erwin620/PrintMAQ/HMI/imagenes/ajustes.png

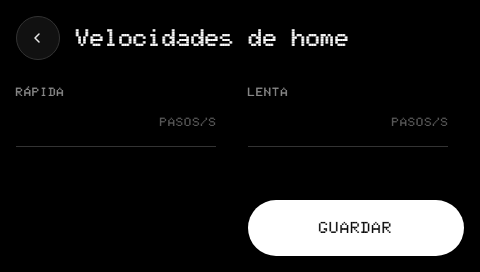
HMI/imagenes/ajustes.png
