erwin620/PrintMAQ/HMI/imagenes/en/ajustes_p.png

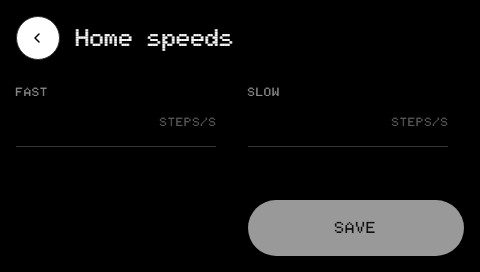
HMI/imagenes/en/ajustes_p.png
