erwin620/PrintMAQ/HMI/imagenes/en/jog.png

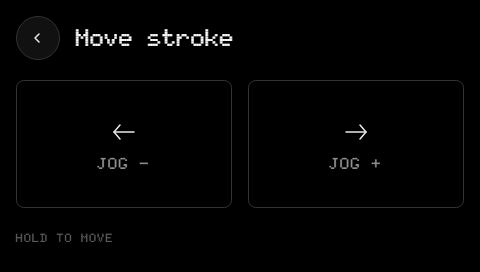
HMI/imagenes/en/jog.png
