erwin620/PrintMAQ/HMI/imagenes/en/jog_p.png

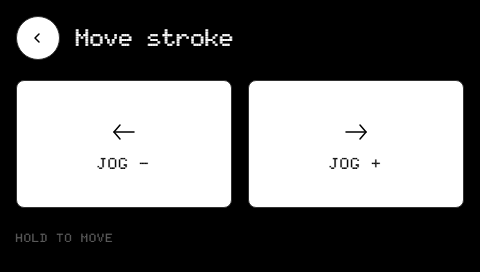
HMI/imagenes/en/jog_p.png
