erwin620/PrintMAQ/HMI/imagenes/en/main.png

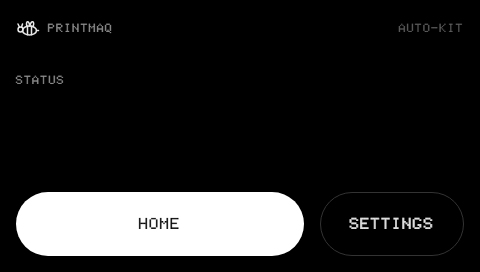
HMI/imagenes/en/main.png
