erwin620/PrintMAQ/HMI/imagenes/en/menu.png

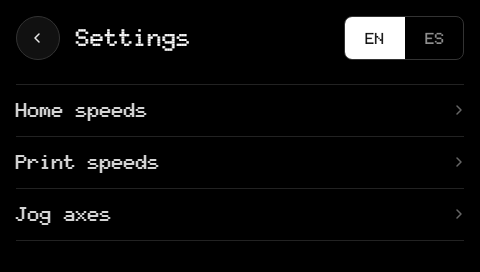
HMI/imagenes/en/menu.png
