erwin620/PrintMAQ/HMI/imagenes/impresion_p.png

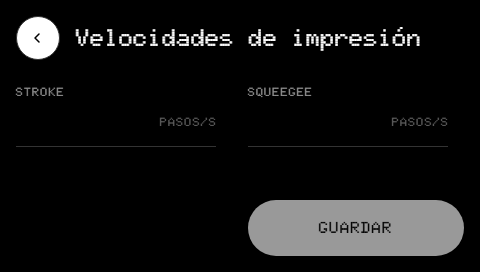
HMI/imagenes/impresion_p.png
