erwin620/PrintMAQ/HMI/imagenes/menu.png

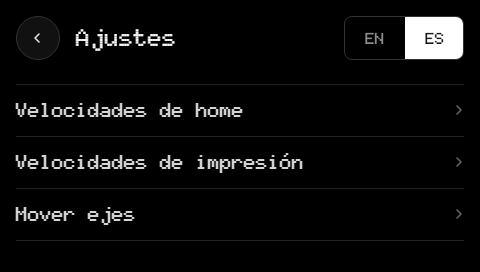
HMI/imagenes/menu.png
