erwin620/PrintMAQ/HMI/imagenes/menu_p.png

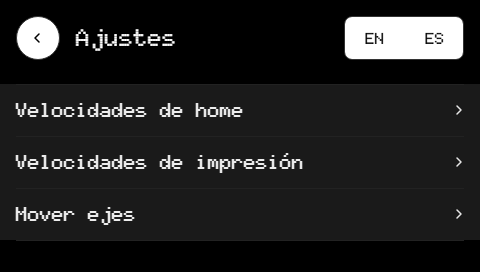
HMI/imagenes/menu_p.png
