erwin620/PrintMAQ/HMI/imagenes/teclado.png

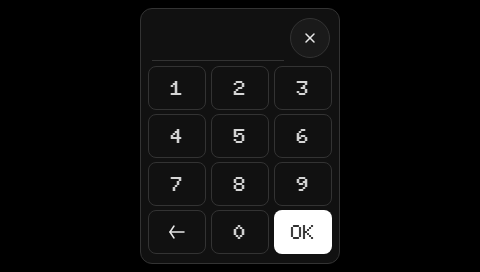
HMI/imagenes/teclado.png
