erwin620/PrintMAQ/HMI/imagenes/teclado_p.png

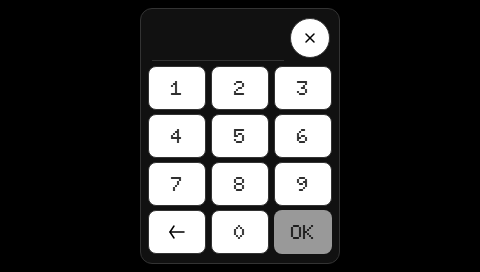
HMI/imagenes/teclado_p.png
