erwin620/PrintMAQ/STM32/Core/Src/main.c

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
/* Includes ------------------------------------------------------------------*/
#include "main.h"
#include "cmsis_os.h"

/* USER CODE BEGIN Includes */
#include "machine.h"
#include "settings.h"
#include "hmi.h"
/* USER CODE END Includes */

/* Definitions for MachineTask */
osThreadId_t MachineTaskHandle;
const osThreadAttr_t MachineTask_attributes = {
  .name = "MachineTask",
  .stack_size = 256 * 4,
  .priority = (osPriority_t) osPriorityAboveNormal,
};
/* Definitions for HmiTask */
osThreadId_t HmiTaskHandle;
const osThreadAttr_t HmiTask_attributes = {
  .name = "HmiTask",
  .stack_size = 256 * 4,
  .priority = (osPriority_t) osPriorityNormal,
};
/* Definitions for LedTask */
osThreadId_t LedTaskHandle;
const osThreadAttr_t LedTask_attributes = {
  .name = "LedTask",
  .stack_size = 128 * 4,
  .priority = (osPriority_t) osPriorityLow,
};
void SystemClock_Config(void);
void StartDefaultTask(void *argument);
void StartTask03(void *argument);
void StartTask04(void *argument);

/* USER CODE BEGIN PFP */
static void MX_GPIO_Init(void);
static void DWT_Init(void);
static void StatusLed_Update(void);
#ifdef PRUEBA_BANCO_SIN_HMI
static void KeyUp_Update(void);
#endif
/* USER CODE END PFP */

/**
  * @brief  The application entry point.
  * @retval int
  */
int main(void)
{

  /* MCU Configuration--------------------------------------------------------*/

  /* Reset of all peripherals, Initializes the Flash interface and the Systick. */
  HAL_Init();

  /* Configure the system clock */
  SystemClock_Config();

  /* Initialize all configured peripherals */
  /* USER CODE BEGIN 2 */
  MX_GPIO_Init();
  DWT_Init();
  Settings_Init();
  Machine_Init();
  Hmi_Init();
  /* USER CODE END 2 */

  /* Init scheduler */
  osKernelInitialize();

  /* USER CODE BEGIN RTOS_MUTEX */
  /* add mutexes, ... */
  /* USER CODE END RTOS_MUTEX */

  /* USER CODE BEGIN RTOS_SEMAPHORES */
  /* add semaphores, ... */
  /* USER CODE END RTOS_SEMAPHORES */

  /* USER CODE BEGIN RTOS_TIMERS */
  /* start timers, add new ones, ... */
  /* USER CODE END RTOS_TIMERS */

  /* USER CODE BEGIN RTOS_QUEUES */
  /* add queues, ... */
  /* USER CODE END RTOS_QUEUES */

  /* Create the thread(s) */
  /* creation of MachineTask */
  MachineTaskHandle = osThreadNew(StartDefaultTask, NULL, &MachineTask_attributes);

  /* creation of HmiTask */
  HmiTaskHandle = osThreadNew(StartTask03, NULL, &HmiTask_attributes);

  /* creation of LedTask */
  LedTaskHandle = osThreadNew(StartTask04, NULL, &LedTask_attributes);

  /* USER CODE BEGIN RTOS_THREADS */
  /* add threads, ... */
  /* USER CODE END RTOS_THREADS */

  /* USER CODE BEGIN RTOS_EVENTS */
  /* add events, ... */
  /* USER CODE END RTOS_EVENTS */

  /* Start scheduler */
  osKernelStart();

  /* We should never get here as control is now taken by the scheduler */

  /* Infinite loop */
  /* USER CODE BEGIN WHILE */
  /* Inalcanzable: osKernelStart no retorna y el trabajo lo hacen las tareas. */
  while (1)
  {
    /* USER CODE END WHILE */

    /* USER CODE BEGIN 3 */
  }
  /* USER CODE END 3 */
}

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
/* USER CODE BEGIN 4 */

/* Configura los LEDs, las salidas STEP/DIR de los ejes y las entradas de los sensores. */
static void MX_GPIO_Init(void)
{
  GPIO_InitTypeDef GPIO_InitStruct = {0};

  __HAL_RCC_GPIOA_CLK_ENABLE();
  __HAL_RCC_GPIOB_CLK_ENABLE();
  __HAL_RCC_GPIOC_CLK_ENABLE();

  /* LEDs activos en bajo: SET = apagado */
  HAL_GPIO_WritePin(LED_D2_PORT, LED_D2_PIN | LED_D3_PIN, GPIO_PIN_SET);
  GPIO_InitStruct.Pin = LED_D2_PIN | LED_D3_PIN;
  GPIO_InitStruct.Mode = GPIO_MODE_OUTPUT_PP;
  GPIO_InitStruct.Pull = GPIO_NOPULL;
  GPIO_InitStruct.Speed = GPIO_SPEED_FREQ_LOW;
  HAL_GPIO_Init(LED_D2_PORT, &GPIO_InitStruct);

  /* PUL/DIR en reposo = LOW (sin corriente por el opto del DM556) */
  HAL_GPIO_WritePin(STROKE_PUL_PORT, STROKE_PUL_PIN, GPIO_PIN_RESET);
  HAL_GPIO_WritePin(STROKE_DIR_PORT, STROKE_DIR_PIN, GPIO_PIN_RESET);
  GPIO_InitStruct.Pin = STROKE_PUL_PIN | STROKE_DIR_PIN;
  GPIO_InitStruct.Mode = GPIO_MODE_OUTPUT_PP;
  GPIO_InitStruct.Pull = GPIO_NOPULL;
  GPIO_InitStruct.Speed = GPIO_SPEED_FREQ_HIGH;
  HAL_GPIO_Init(STROKE_PUL_PORT, &GPIO_InitStruct);

  HAL_GPIO_WritePin(SQUEEGEE_PUL_PORT, SQUEEGEE_PUL_PIN, GPIO_PIN_RESET);
  HAL_GPIO_WritePin(SQUEEGEE_DIR_PORT, SQUEEGEE_DIR_PIN, GPIO_PIN_RESET);
  GPIO_InitStruct.Pin = SQUEEGEE_PUL_PIN | SQUEEGEE_DIR_PIN;
  HAL_GPIO_Init(SQUEEGEE_PUL_PORT, &GPIO_InitStruct);

  /* Sensores NPN de colector abierto: necesitan pull-up */
  GPIO_InitStruct.Pin = STROKE_HOME_PIN | SQUEEGEE_HOME_PIN;
  GPIO_InitStruct.Mode = GPIO_MODE_INPUT;
  GPIO_InitStruct.Pull = GPIO_PULLUP;
  HAL_GPIO_Init(STROKE_HOME_PORT, &GPIO_InitStruct);

  GPIO_InitStruct.Pin = PRENDA_PIN;
  HAL_GPIO_Init(PRENDA_PORT, &GPIO_InitStruct);

#ifdef PRUEBA_BANCO_SIN_HMI
  /* El boton no tiene resistencia externa: sin pull-down la entrada quedaria flotando */
  GPIO_InitStruct.Pin = KEY_UP_PIN;
  GPIO_InitStruct.Mode = GPIO_MODE_INPUT;
  GPIO_InitStruct.Pull = GPIO_PULLDOWN;
  HAL_GPIO_Init(KEY_UP_PORT, &GPIO_InitStruct);
#endif
}

/* El contador de ciclos DWT es la base de tiempo de los pulsos y del filtro del sensor. */
static void DWT_Init(void)
{
  CoreDebug->DEMCR |= CoreDebug_DEMCR_TRCENA_Msk;
  DWT->CYCCNT = 0U;
  DWT->CTRL |= DWT_CTRL_CYCCNTENA_Msk;
}

/* D3 refleja el estado de la maquina: apagado = sin home, parpadeo lento = haciendo home,
   fijo = en home, parpadeo muy lento = jog, parpadeo medio = imprimiendo, parpadeo rapido = error. */
static void StatusLed_Update(void)
{
  uint32_t tick = HAL_GetTick();
  uint8_t led_on;

  switch (Machine_GetState())
  {
    case MAQ_HACIENDO_HOME: led_on = ((tick / 250U) % 2U) == 0U; break;
    case MAQ_EN_HOME:       led_on = 1U;                         break;
    case MAQ_JOG:           led_on = ((tick / 500U) % 2U) == 0U; break;
    case MAQ_IMPRIMIENDO:   led_on = ((tick / 125U) % 2U) == 0U; break;
    case MAQ_ERROR:         led_on = ((tick / 62U) % 2U) == 0U;  break;
    /* Destello corto en vez de apagado: distingue "esperando home" de "firmware detenido" */
    case MAQ_SIN_HOME:
    default:                led_on = (tick % 2000U) < 60U;       break;
  }

  HAL_GPIO_WritePin(LED_D3_PORT, LED_D3_PIN, led_on ? GPIO_PIN_RESET : GPIO_PIN_SET);
}

#ifdef PRUEBA_BANCO_SIN_HMI
/* Se llama cada 20 ms desde LedTask: exigir dos lecturas seguidas presionado filtra el rebote.
   Solo el flanco de presion pide el home; mantener el boton no lo repite. */
static void KeyUp_Update(void)
{
  static uint8_t prev_pressed = 0U;
  static uint8_t last_raw = 0U;
  uint8_t raw = (HAL_GPIO_ReadPin(KEY_UP_PORT, KEY_UP_PIN) == KEY_UP_ACTIVE) ? 1U : 0U;
  uint8_t pressed = (raw && last_raw) ? 1U : 0U;
  Machine_State_t st = Machine_GetState();

  /* D2 refleja el boton mientras ningun eje lo usa como indicador de pasos: confirma en banco que PA0 se lee */
  if (st == MAQ_SIN_HOME || st == MAQ_ERROR)
  {
    HAL_GPIO_WritePin(LED_D2_PORT, LED_D2_PIN, raw ? GPIO_PIN_RESET : GPIO_PIN_SET);
  }

  if (pressed && !prev_pressed)
  {
    Machine_RequestHome();
  }
  prev_pressed = pressed;
  last_raw = raw;
}
#endif

/* USER CODE END 4 */

/* USER CODE BEGIN Header_StartDefaultTask */
/**
  * @brief  Function implementing the defaultTask thread.
  * @param  argument: Not used
  * @retval None
  */
/* USER CODE END Header_StartDefaultTask */
void StartDefaultTask(void *argument)
{
  /* USER CODE BEGIN 5 */
  /* Los pulsos del motor no se generan aqui sino en la interrupcion de TIM7: una tarea
     tendria jitter y estaria limitada a 1 paso por tick del RTOS. */
  for(;;)
  {
    Machine_Update();
    /* Misma tarea que Machine_Update: ningun movimiento puede arrancar a mitad de una grabacion */
    Settings_Update(Machine_IsIdle());
    osDelay(1);
  }
  /* USER CODE END 5 */
}

/* USER CODE BEGIN Header_StartTask03 */
/**
* @brief Function implementing the HmiTask thread.
* @param argument: Not used
* @retval None
*/
/* USER CODE END Header_StartTask03 */
void StartTask03(void *argument)
{
  /* USER CODE BEGIN StartTask03 */
  /* A 9600 baudios llega como maximo un byte por milisegundo y la interrupcion los bufferea,
     por lo que revisar cada 2 ms no pierde datos. */
  for(;;)
  {
    Hmi_Update();
    osDelay(2);
  }
  /* USER CODE END StartTask03 */
}

/* USER CODE BEGIN Header_StartTask04 */
/**
* @brief Function implementing the myTask04 thread.
* @param argument: Not used
* @retval None
*/
/* USER CODE END Header_StartTask04 */
void StartTask04(void *argument)
{
  /* USER CODE BEGIN StartTask04 */
  for(;;)
  {
#ifdef PRUEBA_BANCO_SIN_HMI
    KeyUp_Update();
#endif
    StatusLed_Update();
    osDelay(20);
  }
  /* USER CODE END StartTask04 */
}

/**
  * @brief  Period elapsed callback in non blocking mode
  * @note   This function is called  when TIM6 interrupt took place, inside
  * HAL_TIM_IRQHandler(). It makes a direct call to HAL_IncTick() to increment
  * a global variable "uwTick" used as application time base.
  * @param  htim : TIM handle
  * @retval None
  */
void HAL_TIM_PeriodElapsedCallback(TIM_HandleTypeDef *htim)
{
  if (htim->Instance == TIM6)
  {
    HAL_IncTick();
  }
}

/**
  * @brief  This function is executed in case of error occurrence.
  * @retval None
  */
void Error_Handler(void)
{
  /* USER CODE BEGIN Error_Handler_Debug */
  /* User can add his own implementation to report the HAL error return state */

  /* USER CODE END Error_Handler_Debug */
}
#ifdef USE_FULL_ASSERT
/**
  * @brief  Reports the name of the source file and the source line number
  *         where the assert_param error has occurred.
  * @param  file: pointer to the source file name
  * @param  line: assert_param error line source number
  * @retval None
  */
void assert_failed(uint8_t *file, uint32_t line)
{
  /* USER CODE BEGIN 6 */
  /* User can add his own implementation to report the file name and line number,
     tex: printf("Wrong parameters value: file %s on line %d\r\n", file, line) */
  /* USER CODE END 6 */
}
#endif /* USE_FULL_ASSERT */
