erwin620/PrintMAQ/STM32/Core/Inc/main.h

#define STROKE_PUL_PORT       GPIOC
#define STROKE_PUL_PIN        GPIO_PIN_0
#define STROKE_DIR_PORT       GPIOC
#define STROKE_DIR_PIN        GPIO_PIN_1
#define STROKE_HOME_PORT      GPIOC
#define STROKE_HOME_PIN       GPIO_PIN_6
#define STROKE_HOME_ACTIVE    GPIO_PIN_RESET
#define STROKE_HOME_DIR       GPIO_PIN_RESET
#define SQUEEGEE_PUL_PORT     GPIOC
#define SQUEEGEE_PUL_PIN      GPIO_PIN_3
#define SQUEEGEE_DIR_PORT     GPIOC
#define SQUEEGEE_DIR_PIN      GPIO_PIN_4
#define SQUEEGEE_HOME_PORT    GPIOC
#define SQUEEGEE_HOME_PIN     GPIO_PIN_7
#define SQUEEGEE_HOME_ACTIVE  GPIO_PIN_RESET
#define SQUEEGEE_HOME_DIR     GPIO_PIN_RESET
#define PRENDA_PORT           GPIOB
#define PRENDA_PIN            GPIO_PIN_0
#define PRENDA_ACTIVE         GPIO_PIN_RESET
#define LED_D2_PORT           GPIOA
#define LED_D2_PIN            GPIO_PIN_6
#define LED_D3_PORT           GPIOA
#define LED_D3_PIN            GPIO_PIN_7
#define HMI_PORT              GPIOA
#define HMI_TX_PIN            GPIO_PIN_9
#define HMI_RX_PIN            GPIO_PIN_10
#define HMI_BAUD              9600U
#define KEY_UP_PORT           GPIOA
#define KEY_UP_PIN            GPIO_PIN_0
#define KEY_UP_ACTIVE         GPIO_PIN_SET
