erwin620/PrintMAQ/(commit log)

2026-10-20 PrintMAQ: firmware STM32 con FreeRTOS, HMI Nextion, home y jog del eje stroke
2026-10-20 Reescribe los README: estado real, decisiones de diseno y guia de uso
2026-10-20 Agrega el ciclo de impresion con sensor de prenda y el eje squeegee
    - Home de dos ejes: el squeegee sube a su sensor (PC7) y despues el stroke hace su home.
    - Con la maquina en home, el sensor de prenda (PB0) dispara una sola pasada por prenda:
    stroke afuera 5", squeegee abajo 2", stroke a home y squeegee arriba.
    - Axis_MoveTo / Axis_IsMoving para movimientos a posicion absoluta.
    - Estado "Imprimiendo" en la HMI y en el LED D3.
    - Pasos por pulgada provisionales; falta calibrar y probar en banco.
    - README actualizados.
2026-10-23 Agrega modo de banco sin HMI y latido de estado en D3
    Con PRUEBA_BANCO_SIN_HMI definido, el boton K_UP (PA0) pide el home y D2
    refleja el boton, para probar el home y el ciclo de impresion sin la
    pantalla Nextion. En estado "sin home", D3 da un destello corto cada 2 s
    para distinguir "esperando home" de "firmware detenido".
2026-10-23 Agrega velocidades del ciclo de impresion configurables desde la HMI
    Nuevo comando #I con la velocidad del stroke y del squeegee y #P2 para
    consultarlas. Las velocidades se fijan al iniciar cada ciclo, asi un
    cambio a mitad de ciclo no altera la pasada en curso.
2026-10-23 Cambia los textos y colores de estado de la HMI al estilo Nothing
    Estados en mayusculas con el color en el texto (sistema de diseno Nothing,
    modo oscuro); el error usa el rojo de acento. El mensaje de guardado pasa
    a [GUARDADO].
    [hmi.c]
2026-10-23 Agrega idioma ingles/espanol guardado en flash
    El STM32 guarda el idioma en el sector 7 de la flash (settings.c) y lo
    envia a la pantalla en main.va_lang; ingles por defecto. Los textos de
    estado y de guardado salen en el idioma activo y el comando #L lo cambia.
    Borrar el sector detiene la CPU 1-2 s, y con ella la interrupcion de
    pulsos, asi que la grabacion es diferida y solo ocurre con la maquina
    detenida (Machine_IsIdle). El linker se recorta a 384K para que el
    programa nunca ocupe ese sector.
2026-10-23 Agrega maqueta, imagenes y logo de la HMI
    HMI/preview dibuja las pantallas a tamano real (estilo Nothing, en ingles
    y espanol); render.html genera los fondos de HMI/imagenes que usa la
    Nextion con botones crop image (normal y presionado, ingles en en/).
    Logo provisional: abeja monolinea.
